frenchie68/Z79Forth/KIMG0091.jpg

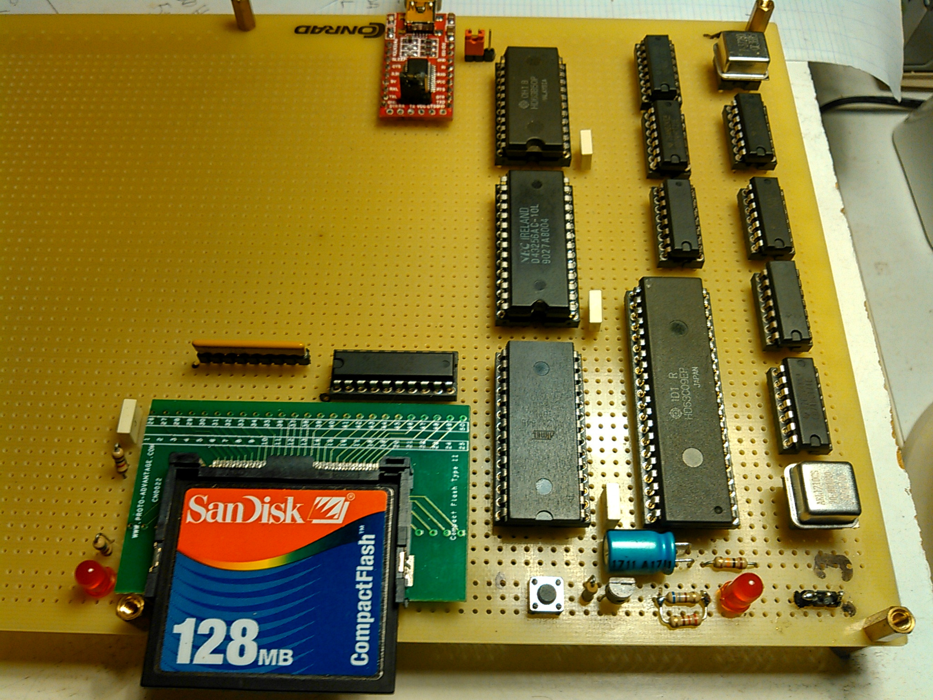
KIMG0091.jpg
