frenchie68/Z79Forth/HW/Z79Forth-iteration2.2.2.pdf

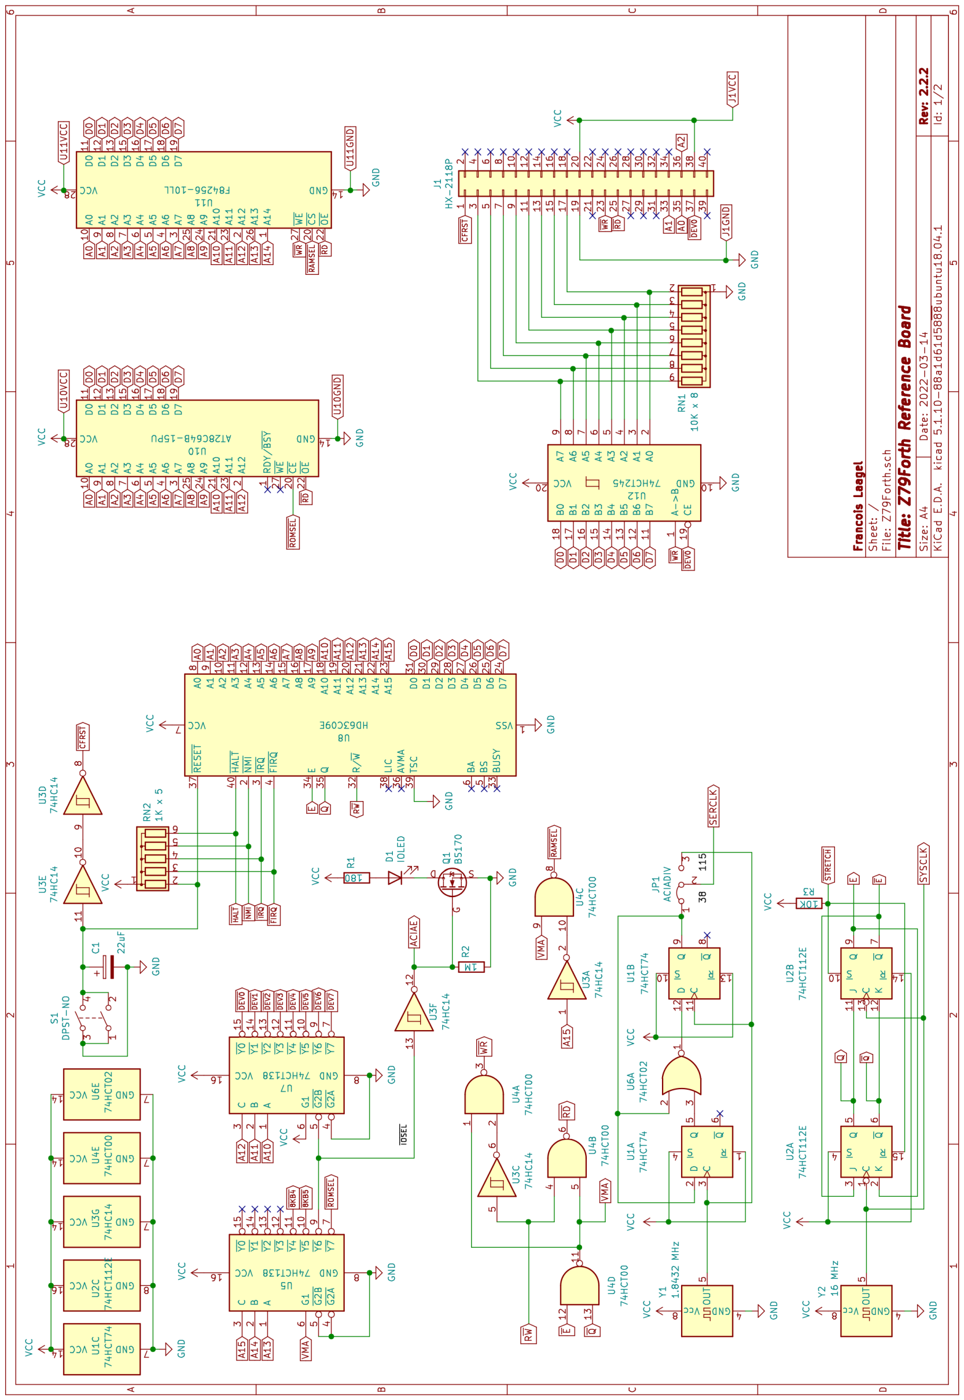
[picture p2: page 1]
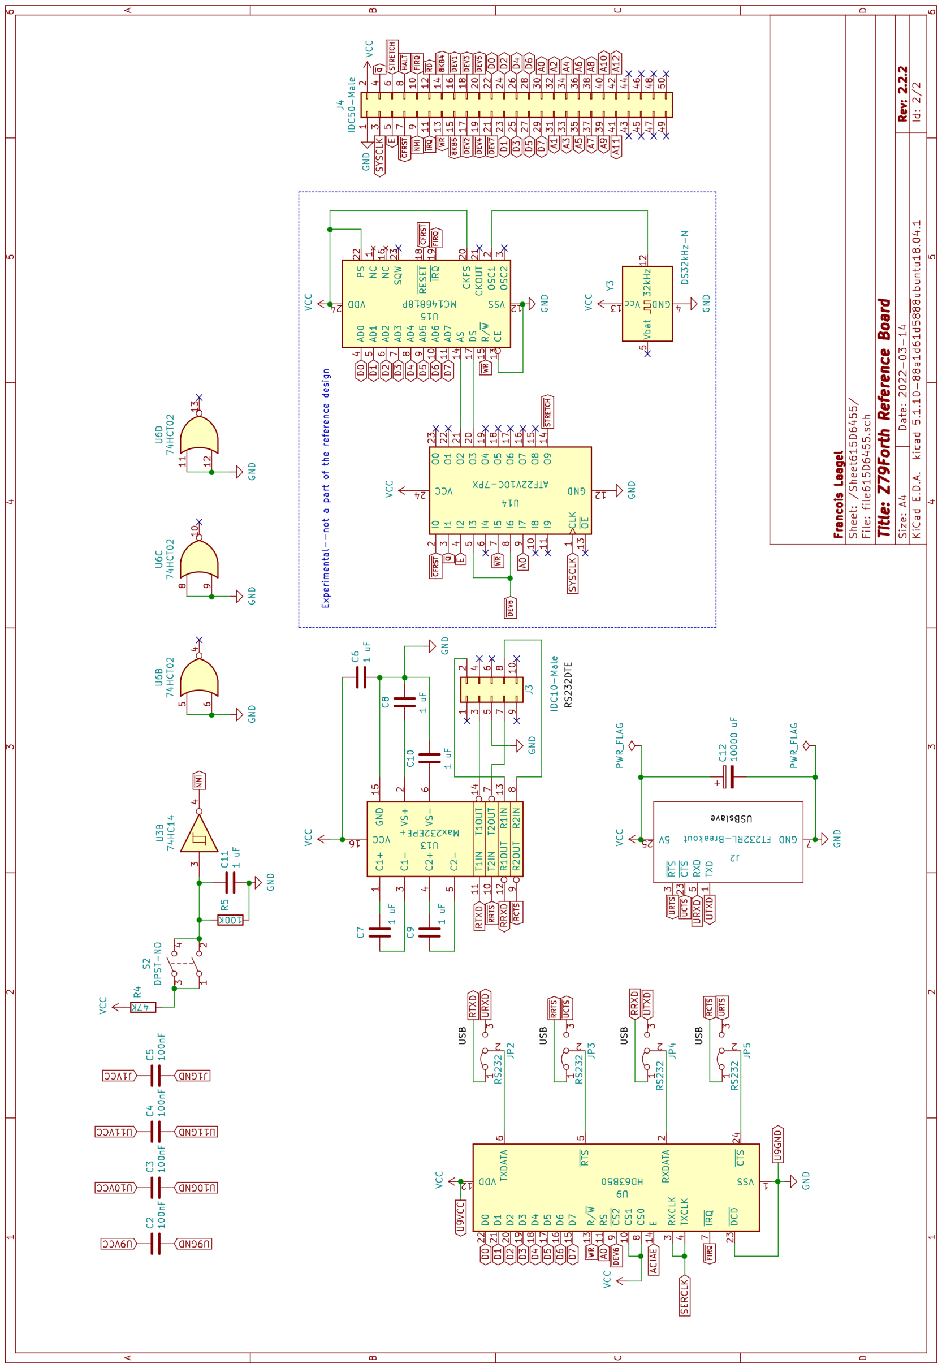
[picture p3: page 2]
