frenchie68/Z79Forth/HW/kicad5/Z79Forth.ods

Ref | Qnty | Value | Actual PN | Footprint | Description | Vendor | Sourcing status | Alternate reference
C1 | 1 | 22uF | C_Polarized |  | Polarized capacitor | Generic
C2, C3, C4, C5 | 4 | 100nF | C |  | Unpolarized capacitor | Generic
C6, C7, C8, C9, C10 | 5 | 1 uF | C |  | Unpolarized capacitor | Generic
D1 | 1 | IOLED | LED | 5 mm diameter | Red Light emitting diode | Generic
J1 | 1 | IDC40-Male | IDC40-Male | 2 rows of 20 pin headers (2.54 mm pitch) | Generic connector, double row, 40 pins, odd/even pin numbering scheme (row 1 odd numbers, row 2 even numbers) | Generic
J2 | 1 |  |  | PDIP28 (holes required for pins 1-9 and 20-28). 2 rows of 9 pin headers | FT232RL-Breakout module connection support | Az-delivery DE
J3 | 1 | IDC10-Male | IDC10-Male | 2 rows of 5 pin headers (2.54 mm pitch) | Generic connector, double row, 10 pins, odd/even pin numbering scheme (row 1 odd numbers, row 2 even numbers) | Generic
J4 | 1 | IDC50-Male | IDC50-Male | 2 rows of 25 pin headers (2.54 mm pitch) | Generic connector, double row, 50 pins, odd/even pin numbering scheme (row 1 odd numbers, row 2 even numbers) | Generic
JP1 | 1 | ACIADIV | Jumper_3_Bridged12 |  | Jumper, 3-pole, pins 1+2 closed/bridged | Generic
JP2, JP3, JP4, JP5 | 4 | RS232 | Jumper_3_Bridged12 |  | Jumper, 3-pole, pins 1+2 closed/bridged | Generic
Q1 | 1 | BS170 | BS170 | TO92 | N-MOSFET transistor, drain/gate/source | Fairchild/Onsemi | Mouser: not before 23/02. Farnell OK (E .4 a pop)
R1 | 1 | 180 | R | 250 mW vertically mounted | Resistor | Generic
R2 | 1 | 1M | R | 250 mW horizontally mounted | Resistor | Generic
R3, R4, R5 | 3 | 10K | R | 250 mW vertically mounted | Resistor | Generic
RN1 | 1 | 10K x 8 | R_Network08 | SIP9 | 8 resistor network, star topology, bussed resistors, small symbol | Bourns through-hole/generic
RN2 | 1 | 10K x 5 | R_Network05 | SIP6 | 5 resistor network, star topology, bussed resistors, small symbol | Bourns through-hole/generic
S1 | 1 | DPST-NO | SW_DPST | 6 x 6 mm | Double Pole Single Throw (DPST) Switch | Generic
U1 | 1 | 74HCT74 | CD74HCT74E | PDIP14 | Dual D Flip-flop, Set & Reset | Generic
U2 | 1 | 74HCT112E | CD74HCT112E | PDIP16 | Dual JK Flip-Flop, Set & Reset | Texas Instruments
U3 | 1 | 74HC14 | CD74HC14E | PDIP14 | Hex inverter schmitt trigger | Texas Instruments
U4 | 1 | 74HCT00 | CD74HCT00E | PDIP14 | quad 2-input NAND gate | Texas Instruments
U5, U7 | 2 | 74HCT138 | SN74HCT138N | PDIP16 | Decoder 3 to 8 active low outputs | Texas Instruments
U6 | 1 | 74HCT02 | SN74HCT02N | PDIP14 | quad 2-input NOR gate | Texas Instruments
U8 | 1 | HD63C09EP | HD63C09EP | PDIP40 | 8-Bit Microprocessing unit 3.0MHz, DIP-40 | Hitachi
U9 | 1 | HD63B50P | HD63B50P | PDIP24 | Asynchronous Communications Interface Adapter 1MHz, DIP-40 | Hitachi
U10 | 1 | AT28C64B-15PU | AT28C64B-15PU | PDIP28 | EEPROM 8 KB 150 ns | Atmel/Microchip | Sourced. (Mouser: 22/07) | https://www.mouser.fr/ProductDetail/Microchip-Technology-Atmel/AT28C64B-15PU
U11 | 1 | F84256-10LL | F84256-10LL | PDIP28 | SRAM 8 KB 100 ns | Fujitsu | Sourced. Wigi has more for a song | NEC D43256AC-10L
U12 | 1 | 74HCT245 | CD74HCT245E | PDIP20 | Octal BUS Transceivers, 3-State outputs | Texas Instruments
U13 | 1 | Max232IN | Max232IN | PDIP16 | Dual EIA-232 Drivers/Receivers | Maxim Integrated
Y1 | 1 | 1.84320 MHz | CXO_DIP8 | Oscillator:Oscillator_DIP-8 | Crystal Clock Oscillator, DIP8-style metal package | Quantek
Y2 | 1 | 16 MHz | CXO_DIP8 | Oscillator:Oscillator_DIP-8 | Crystal Clock Oscillator, DIP8-style metal package | AEL Crystals
unspec | 1 | HX-2118P | HX-2118P | N/A | ATA/CF 8 bit adapter | Ebay |  | https://m.alibaba.com/product/60814179118/Compact-Flash-CF-to-3-5.html
unspec | 1 | FT232RL-Breakout | FT232RL-Breakout | N/A | FT232RL-Breakout module | Az-delivery DE
unspec | 1 | SDCFB-128 | SDCFB-128 | N/A | SanDisk 128 MB (or larger) CompactFlash card | Ebay | Sourced
