frenchie68/Z79Forth/(threads)

Thread 4 (2021-02-05):

THRU does not do the right thing

frenchie68, 2021-02-05:
If invoked from block context, the current implementation (LOAD based) does not seem to be able to properly detect end of standalone blocks. It results in a return stack overflow. I do not clearly understand why, at this point.

I may very well be that a proper implementation should rely on BLOCK/INTERPRET instead.

frenchie68, 2021-03-01:
Fixed in Rel-1.0.2.

Closed 2021-03-01.

Thread 5 (2021-03-20):

POSTPONE Does Not Implement Proper ANSI Semantics

frenchie68, 2021-03-20:
Currently, POSTPONE is a straight alias to [COMPILE]. This means that its application to non-immediate words is problematic. This needs to be fixed and it will.

frenchie68, 2021-03-21:
This is fixed in master but not in any committed release as of yet.
Keeping the issue open until I can put an up to date release together.

frenchie68, 2021-04-05:
The issued has been fixed in the latest master "non-release."

Closed 2021-04-05.

Thread 6 (2021-05-12):

not a issue but why using 74hc14 ?

agsb, 2021-05-12:

frenchie68, 2021-05-13:
Hi Alvaro,

Actually, I do use an 74HC14. The schematics has just not been updated to reflect that.
This brings power consumption down by a few milli-amps.

Are you building the board? I am experimenting with interrupt support (FIRQ in native mode).
Ideally I will have interrupt based serial communications by the end of the weekend.

All the best.

        Francois

agsb, 2021-05-13:
Not for now, but i got curious about forth implementation and why use 74hct14 in main hardware design.
thanks.

frenchie68, 2021-06-18:
The use of a 74HC14 as a substitute for a 74HCT14 is a perfectly working option. I am operating under these conditions myself.

Closed 2021-06-18.

Thread 7 (2021-06-18):

S" skips leading spaces and it should not

frenchie68, 2021-06-18:
This leads to unfortunate outputs like the following:

."                foo" foo OK

This is not detected by the ANSI test suite-- not that it is an easy condition to detect anyway. Still,  I consider this problematic and I will work on a fix.

frenchie68, 2021-06-21:
Traced back to a faulty implementation of WORD.

frenchie68, 2021-06-23:
I now have an uncommitted fix for this. However, since my implementation of S" relies on WORD, it causes it to accept unwarranted leading delimiters whereas GNU Forth barfs (correctly) an error message. Case in point:

[Z79Forth]
S" """ABC" TYPE ABC OK
S" ABC" TYPE ABC OK

[GNU Forth]
S" """ABC" TYPE
:1: Undefined word
S" ">>>""ABC"<<< TYPE
Backtrace:
$7F692E7FAA08 throw
$7F692E810C90 no.extensions
$7F692E7FACC8 interpreter-notfound1

This is, of course, fixable as well but I do not really see the point. At this point, I have 18 bytes of EEPROM left and I will leave it at that.

frenchie68, 2021-07-08:
This issue is fixed in the REL-1.0.5 release.

Closed 2021-07-08.

Thread 9 (2021-07-17):

FORGET does not handle >IN properly

frenchie68, 2021-07-17:
BYE PAGE
HANLOAD 8 TOWERS [On interrupt] \<SPACE\> VLIST
towers Undefined

frenchie68, 2021-07-18:
This turns out not to be a problem--spurious bug report of some sort. Sorry about the noise.

Closed 2021-07-18.

Thread 10 (2021-08-09):

Bug in Schematics version 2.1

frenchie68, 2021-08-09:
Q# (U4 pin 13) is connected to U2 pin 8 and _not_ pin 9. I am not sure whether this will ever be fixed. The whole thing is meant to be replaced with version 2.2 schematics, aka the interrupt based serial communication architecture.

frenchie68, 2022-10-07:
WON'T FIX.

Closed 2022-10-07.

Thread 11 (2022-01-06):

>IN is not updated properly on number to string conversion or on non-immediate words when compiling

frenchie68, 2022-01-06:
This affects the currently published version of master as of this writing. This fix is trivial but unpublished as yet.

frenchie68, 2022-01-26:
Fixed in REL-2.0.1.

frenchie68, 2024-08-28:
This fix needs to be validated thoroughly.

Thread 19 (2023-08-27):

The CompactFlash Debug Code does not do what it's Supposed to

frenchie68, 2023-08-27:
A bug that will be invisible to most users but a bug nonetheless.
X is incorrectly used to point to a string buffer whereas Y should be used instead.

I came across this problem when attempting to debug a non-working SD to CF adapter from a non-descript manufacturer (QUMOX?). I am still missing a solution for that device.

frenchie68, 2023-11-25:
Closed in the REL-ANS94 branch. Master remains to be updated.

Closed 2023-11-25.

Thread 20 (2024-02-18):

ERRHDLR should EMIT an ASCII Shift in Before Anything

frenchie68, 2024-02-18:
This is an extremely marginal concern and yet I do care about it enough. When using alternate character sets on the VT420, the error handler does not currently switch back to the default character set. It _really_ should!

frenchie68, 2024-02-19:
Fixed in the ANS94 branch under REL-3.0.5. The master branch (79-STANDARD) will not get a fix.

Closed 2024-02-19.

Thread 23 (2024-10-22):

Hardware Bug - All schematics Versions

frenchie68, 2024-10-22:
A design flaw exists in the way the EEPROM interfaces to the system. This can cause the firmware to be corrupted and the board to be inoperable without re-flashing the EEPROM.

This happens, occasionally, when the system stack pointer register (S) clashes with the end of the dictionary.

Workaround: please connect pin #27 (WE#) to pin #28 (Vcc) of U10.

frenchie68, 2025-02-25:
Fixed with schematics v0_4, included in release 3.0.8.

Closed 2025-02-25.
