frenchie68/Z79Forth/HW/kicad6/schematics-v0_4.pdf

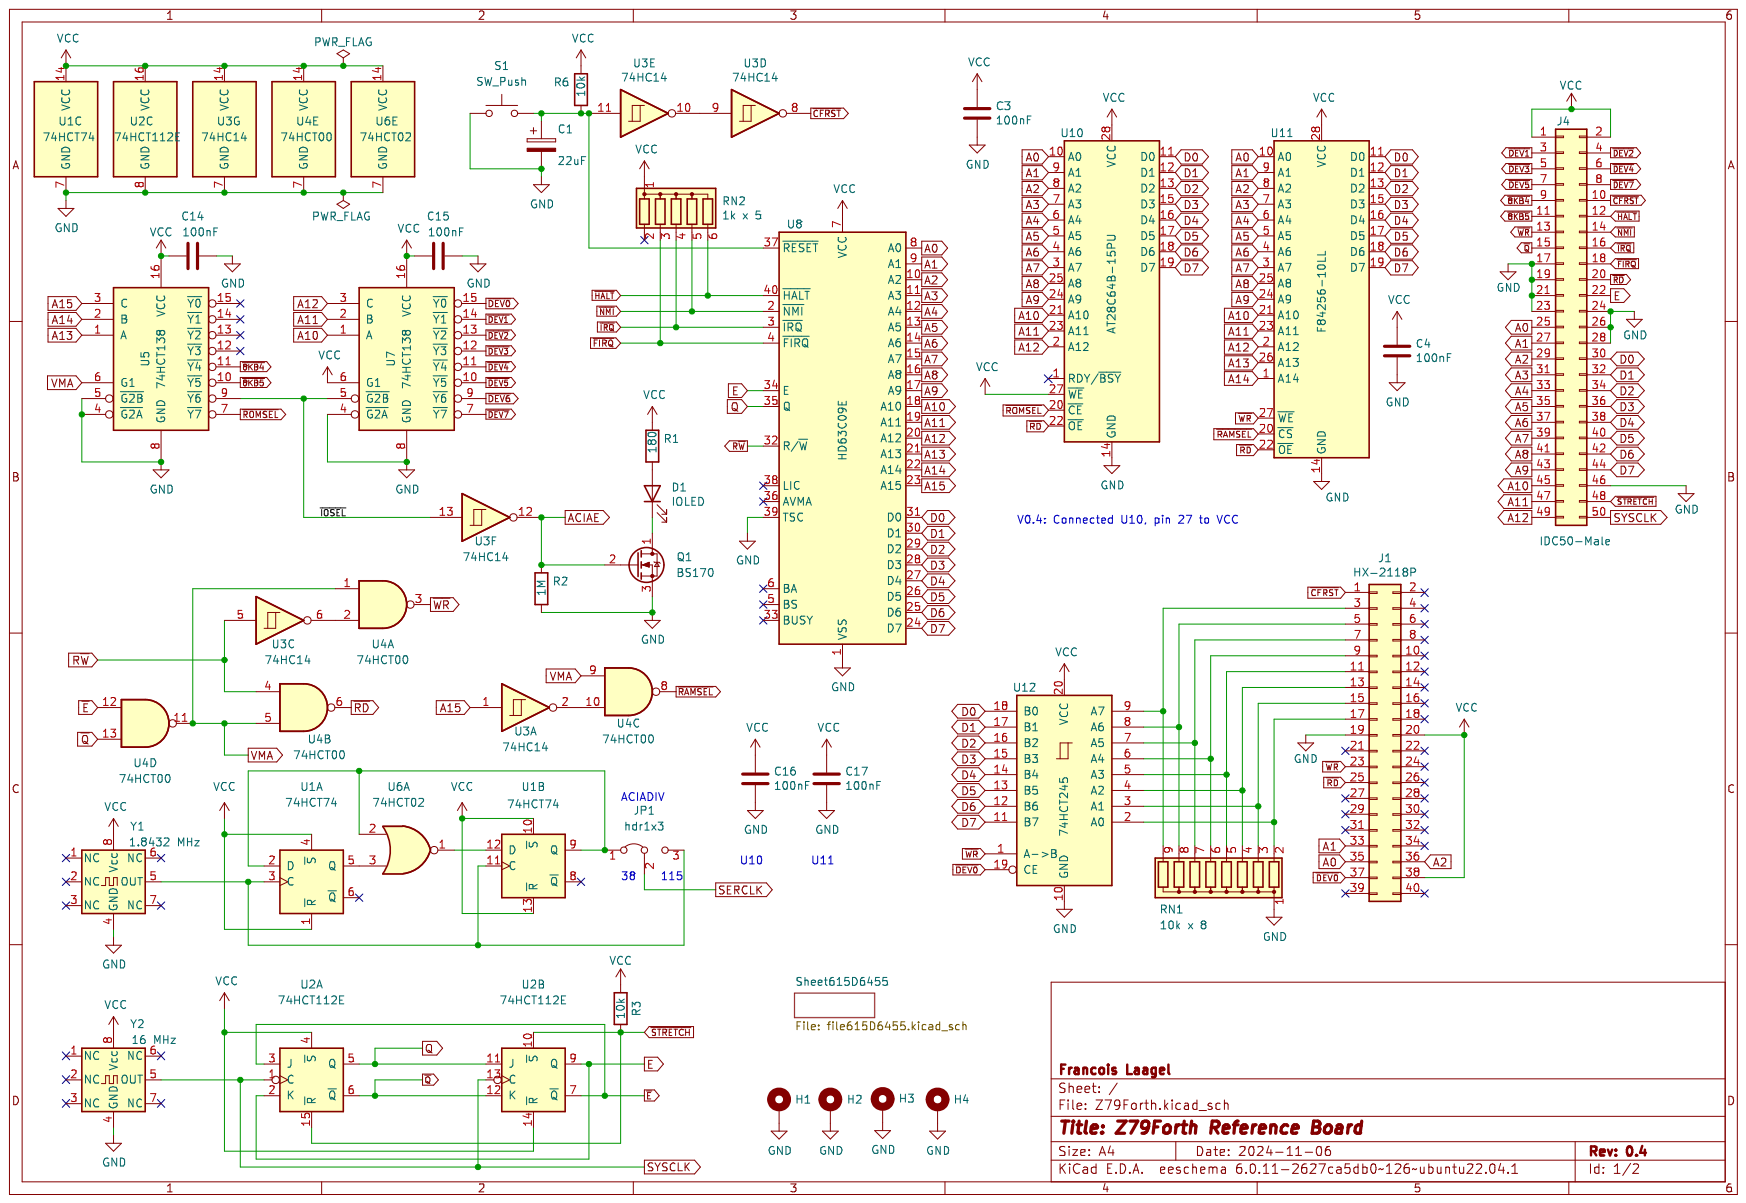
[picture p4: page 1]

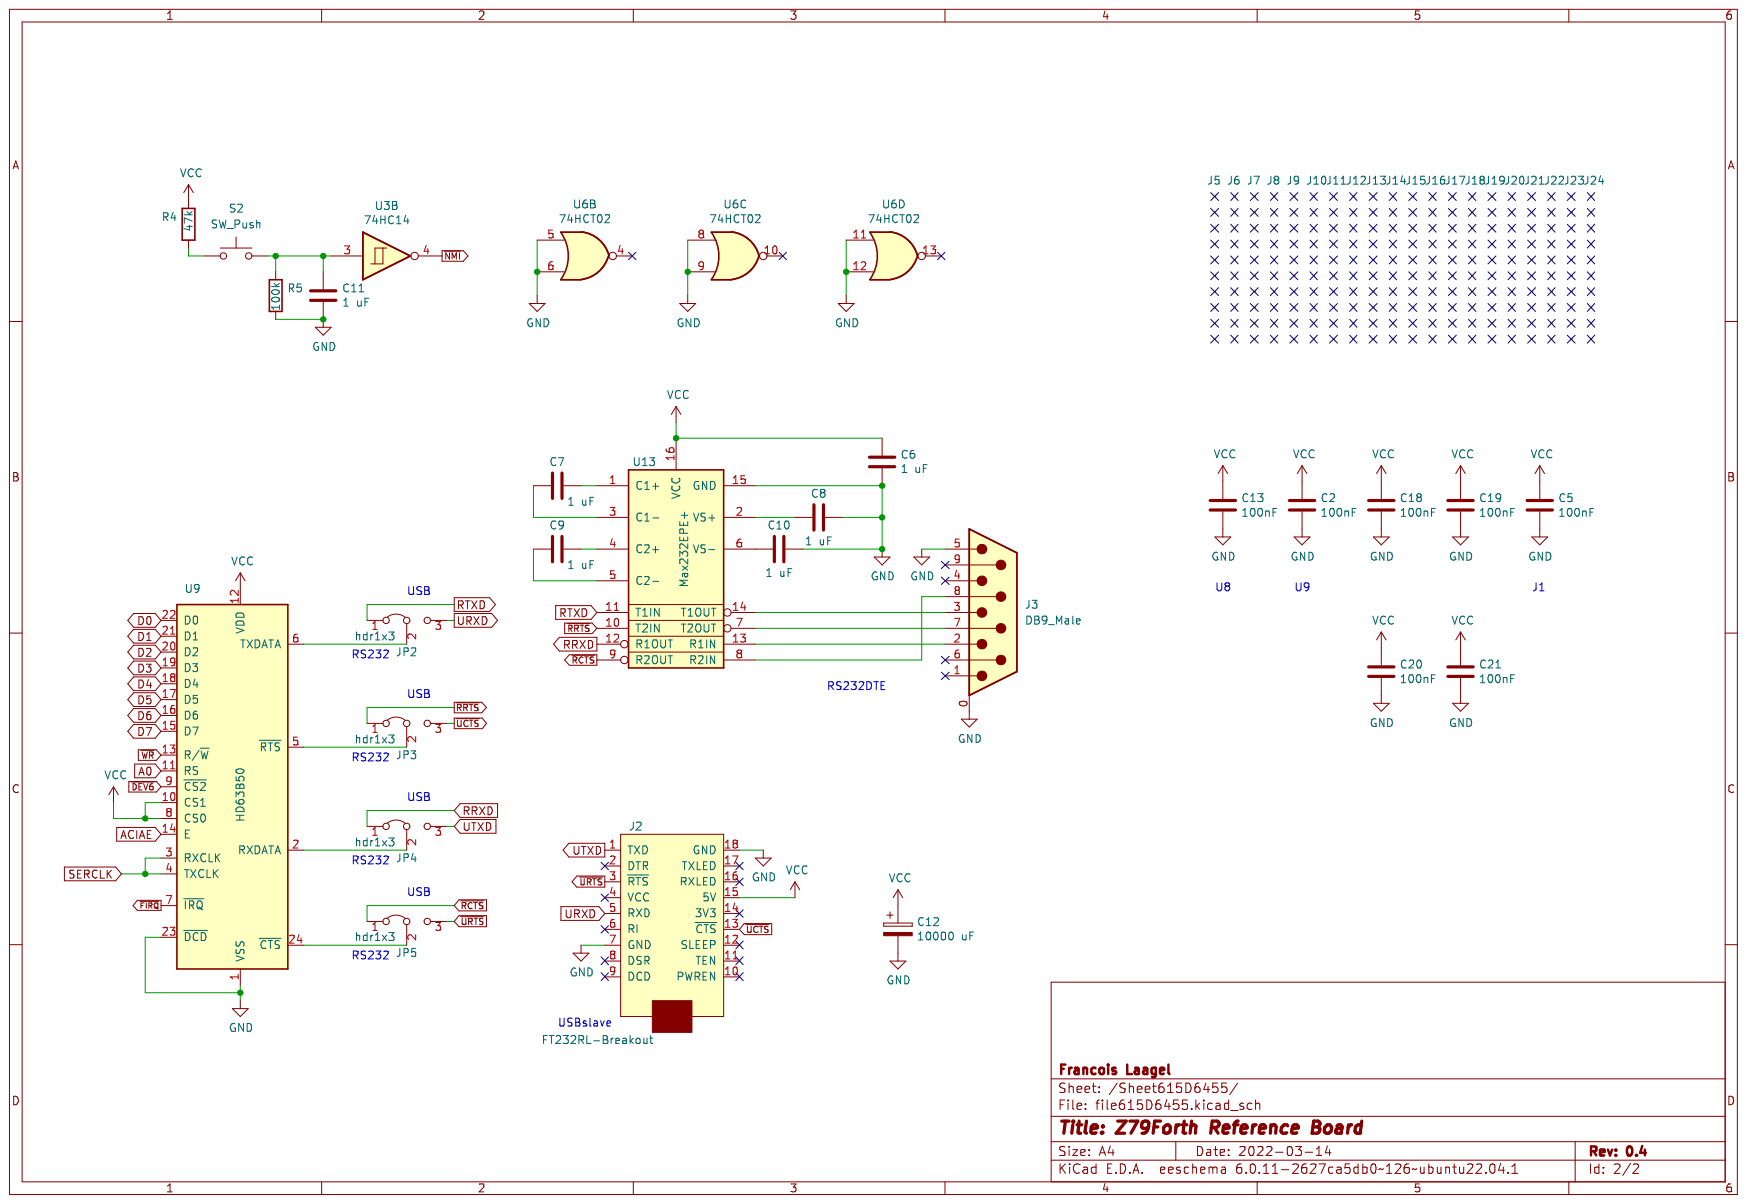
[picture p5: page 2]
