frenchie68/Z79Forth/HW/kicad6/schematics-v0_3.pdf

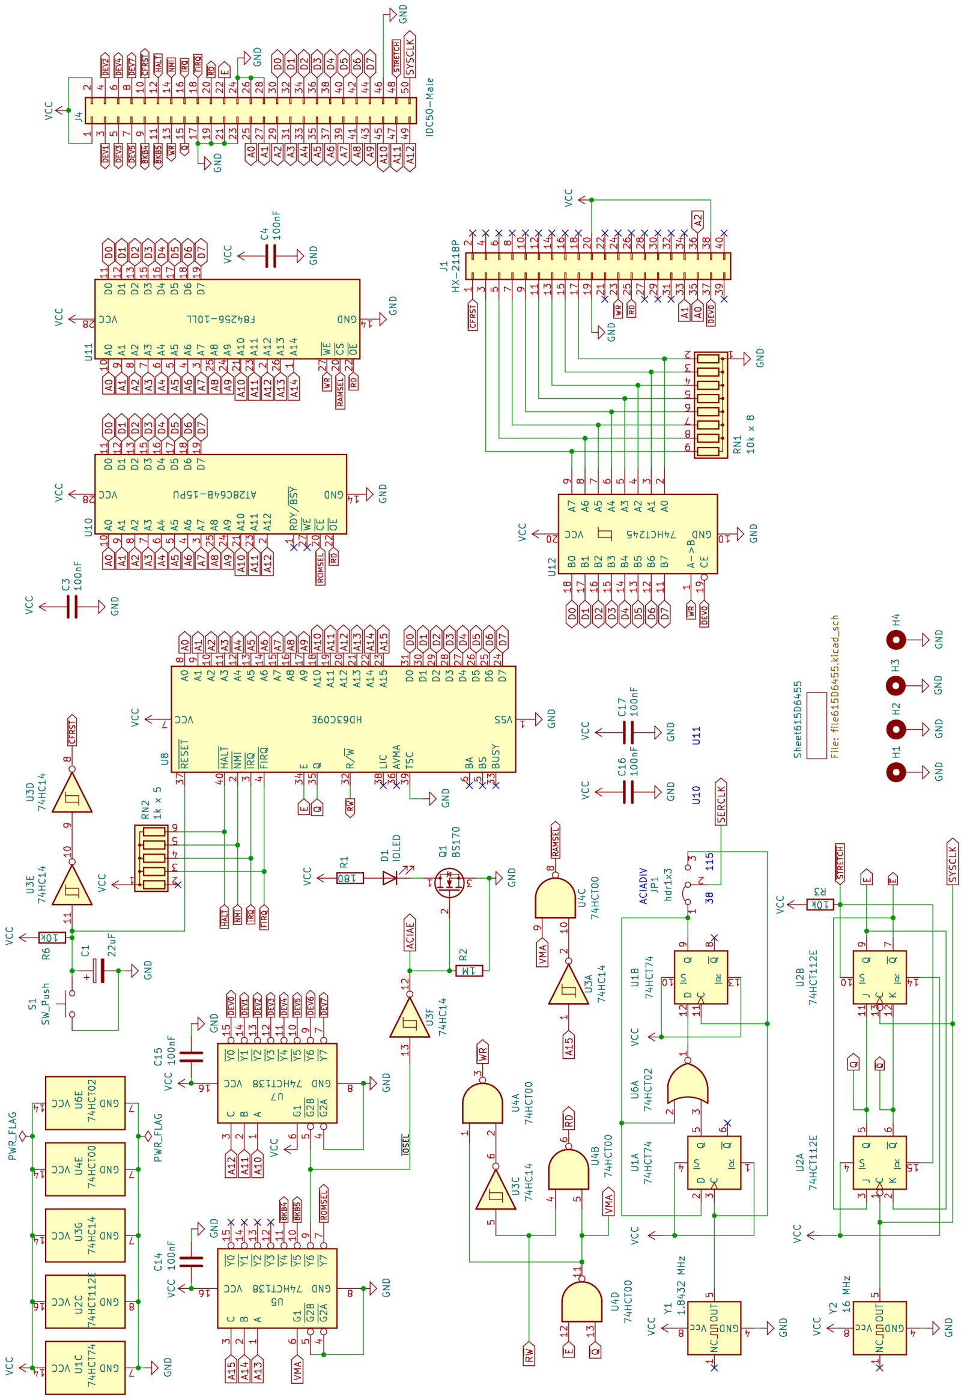
[picture p6: page 1]
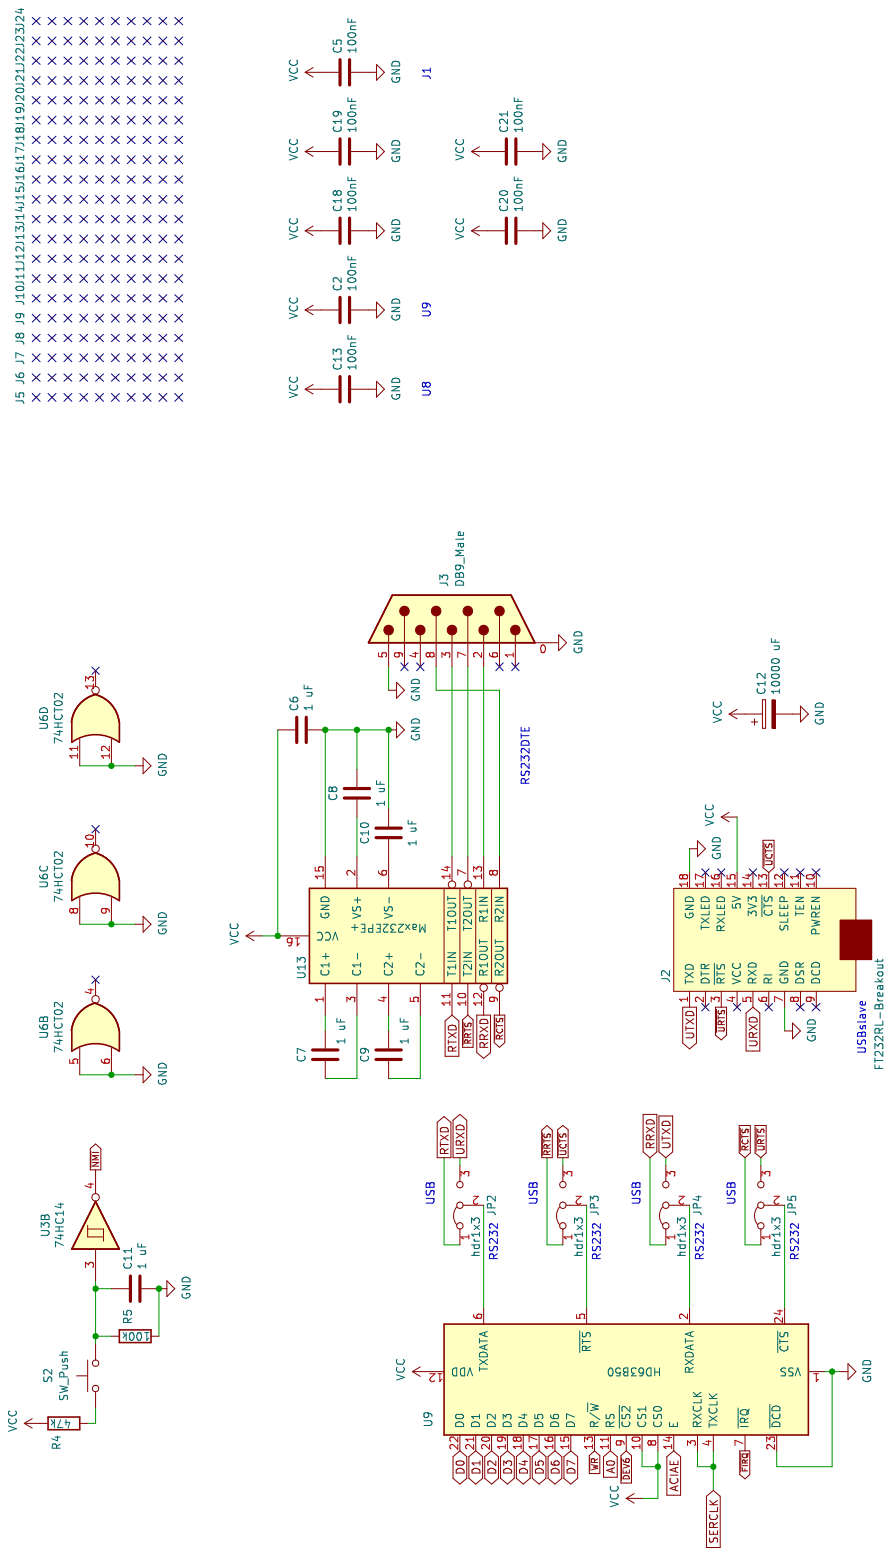
[picture p7: page 2]
