frenchie68/Z79Forth/HW/kicad5/Z79Forth.sch

## KiCad design HW/kicad5/Z79Forth.sch (2022-03-14)

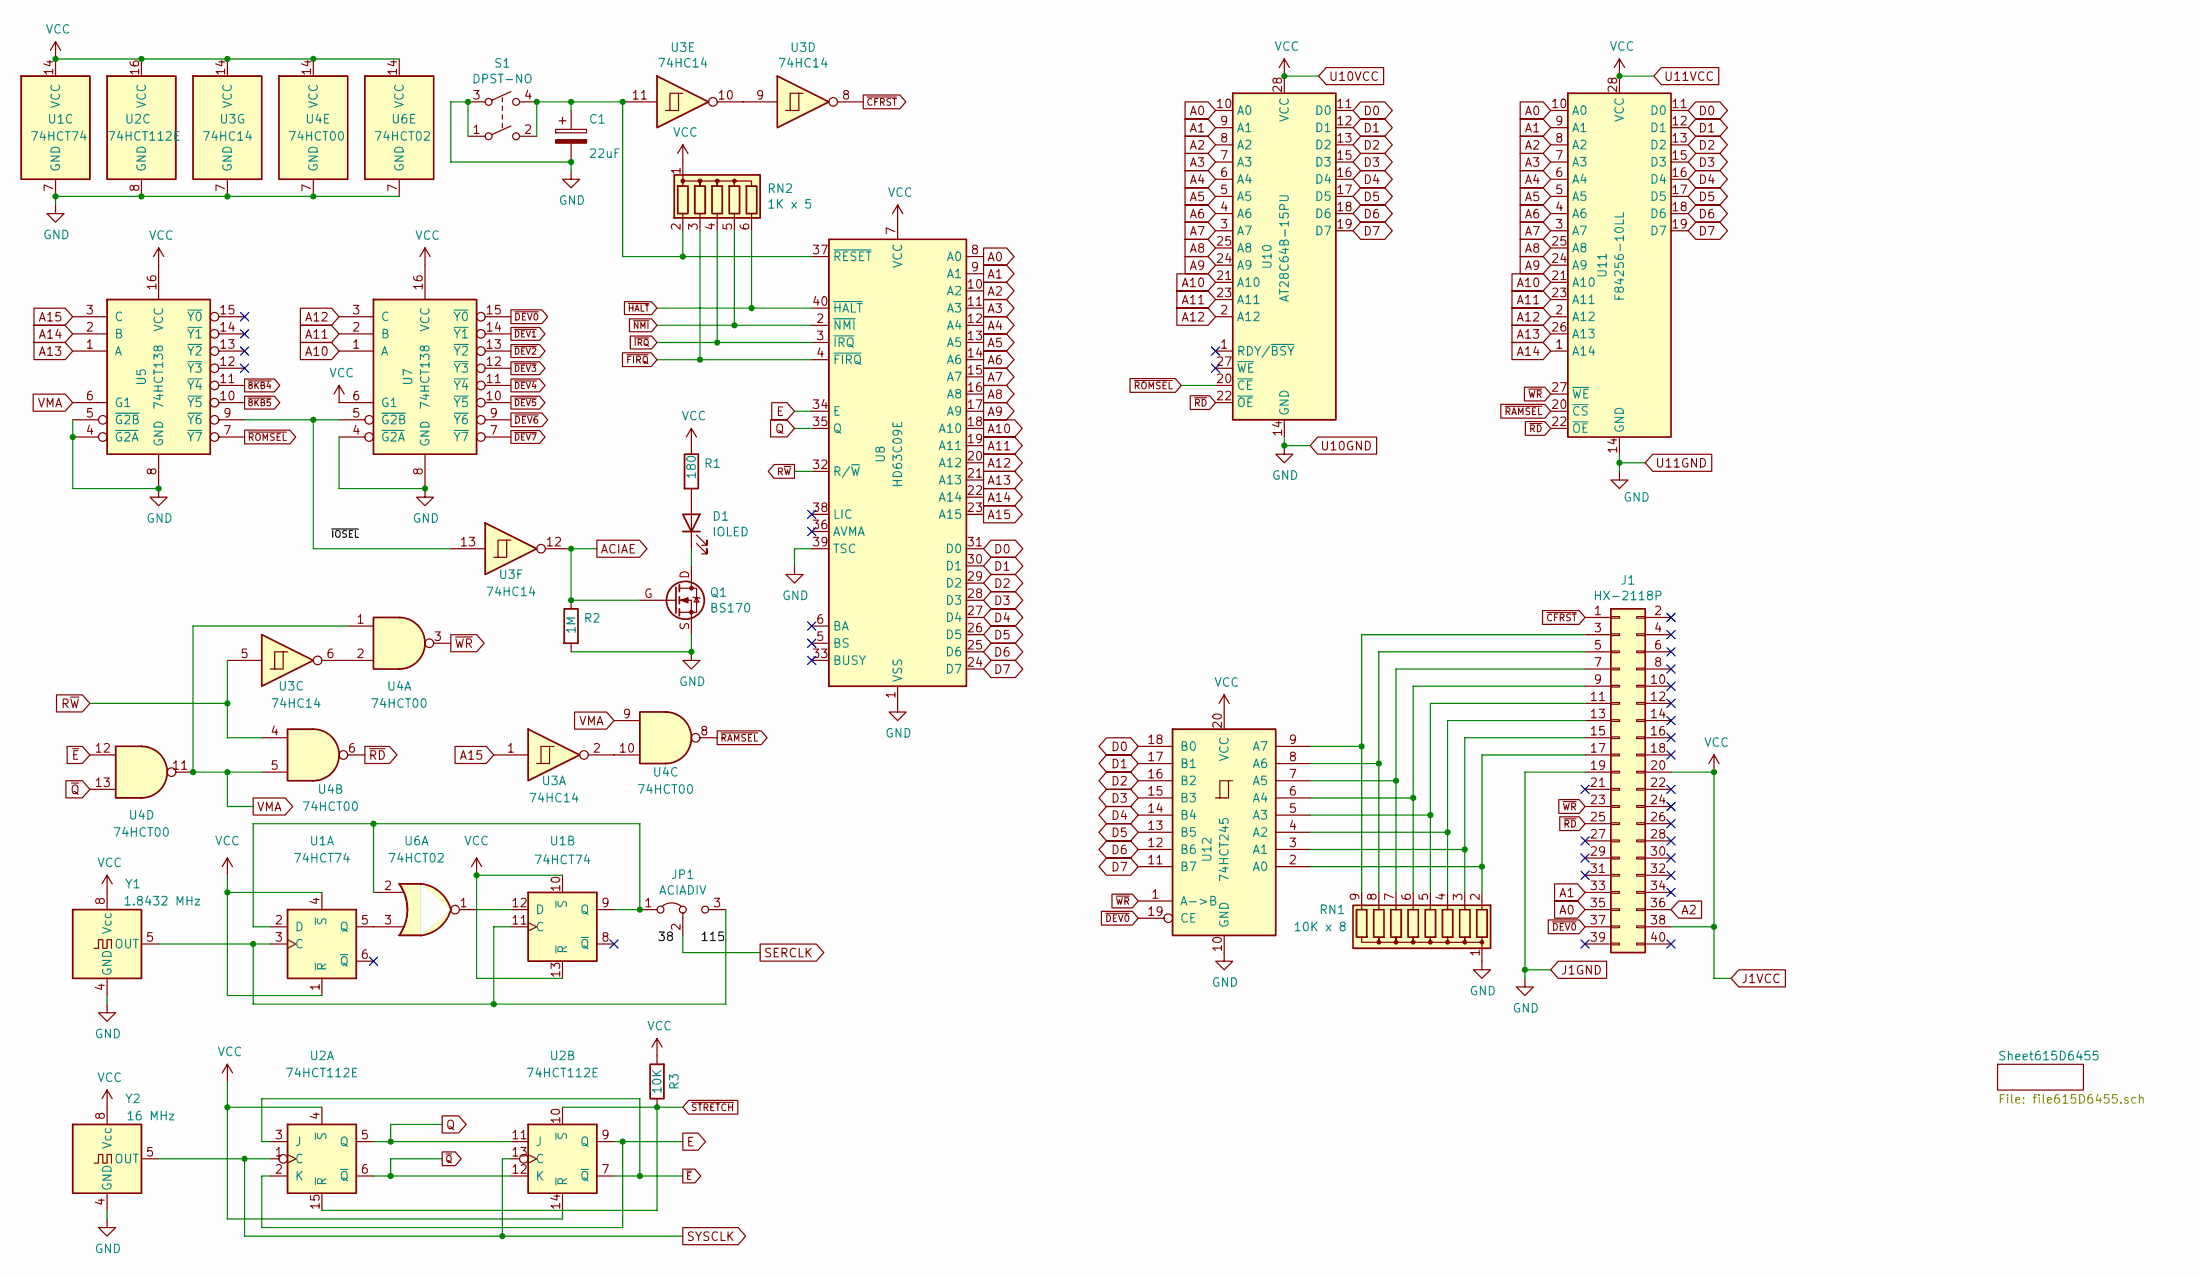
[picture p8: schematic Z79Forth.sch]

Parts:
C1: 22uF
D1: IOLED
J1: HX-2118P
JP1: ACIADIV
Q1: BS170
R1: 180
R2: 1M
R3: 10K
RN1: 10K x 8; R_Array_SIP9
RN2: 1K x 5; R_Array_SIP6
S1: DPST-NO
U1: 74HCT74
U2: 74HCT112E
U3: 74HC14
U4: 74HCT00
U5, U7: 74HCT138
U6: 74HCT02
U8: HD63C09E; DIP-40_W15.24mm
U10: AT28C64B-15PU; DIP-28_W15.24mm
U11: F84256-10LL; DIP-28_W15.24mm
U12: 74HCT245
Y1: 1.8432 MHz; Oscillator_DIP-8
Y2: 16 MHz; Oscillator_DIP-8

Connections:
A0: J1.35, U8.8 (A0), U10.10 (A0), U11.10 (A0)
A1: J1.33, U8.9 (A1), U10.9 (A1), U11.9 (A1)
A2: J1.36, U8.10 (A2), U10.8 (A2), U11.8 (A2)
A3: U8.11 (A3), U10.7 (A3), U11.7 (A3)
A4: U8.12 (A4), U10.6 (A4), U11.6 (A4)
A5: U8.13 (A5), U10.5 (A5), U11.5 (A5)
A6: U8.14 (A6), U10.4 (A6), U11.4 (A6)
A7: U8.15 (A7), U10.3 (A7), U11.3 (A7)
A8: U8.16 (A8), U10.25 (A8), U11.25 (A8)
A9: U8.17 (A9), U10.24 (A9), U11.24 (A9)
A10: U7.1 (A), U8.18 (A10), U10.21 (A10), U11.21 (A10)
A11: U7.2 (B), U8.19 (A11), U10.23 (A11), U11.23 (A11)
A12: U7.3 (C), U8.20 (A12), U10.2 (A12), U11.2 (A12)
A13: U5.1 (A), U8.21 (A13), U11.26 (A13)
A14: U5.2 (B), U8.22 (A14), U11.1 (A14)
A15: U3.1, U5.3 (C), U8.23 (A15)
ACIAE: Q1.G, R2.1, U3.12
D0: U8.31 (D0), U10.11 (D0), U11.11 (D0), U12.18 (B0)
D1: U8.30 (D1), U10.12 (D1), U11.12 (D1), U12.17 (B1)
D2: U8.29 (D2), U10.13 (D2), U11.13 (D2), U12.16 (B2)
D3: U8.28 (D3), U10.15 (D3), U11.15 (D3), U12.15 (B3)
D4: U8.27 (D4), U10.16 (D4), U11.16 (D4), U12.14 (B4)
D5: U8.26 (D5), U10.17 (D5), U11.17 (D5), U12.13 (B5)
D6: U8.25 (D6), U10.18 (D6), U11.18 (D6), U12.12 (B6)
D7: U8.24 (D7), U10.19 (D7), U11.19 (D7), U12.11 (B7)
E: U2.2 (K), U2.9 (Q), U8.34 (E)
GND: C1.2, J1.19, Q1.S, R2.2, RN1.1 (common), S1.1, S1.3, U1.7 (GND), U2.8 (GND), U3.7 (GND), U4.7 (GND), U5.4 (~G2A), U5.5 (~G2B), U5.8 (GND), U6.7 (GND), U7.4 (~G2A), U7.8 (GND), U8.1 (VSS), U8.39 (TSC), U10.14 (GND), U11.14 (GND), U12.10 (GND), Y1.4 (GND), Y2.4 (GND)
J1VCC: J1.20, J1.38, R1.1, R3.2, RN2.1 (common), U1.1 (~R), U1.4 (~S), U1.10 (~S), U1.13 (~R), U1.14 (VCC), U2.4 (~S), U2.14 (~R), U2.16 (VCC), U3.14 (VCC), U4.14 (VCC), U5.16 (VCC), U6.14 (VCC), U7.6 (G1), U7.16 (VCC), U8.7 (VCC), U10.28 (VCC), U11.28 (VCC), U12.20 (VCC), Y1.8 (Vcc), Y2.8 (Vcc)
unnamed: C1.1, RN2.2 (R1), S1.2, S1.4, U3.11, U8.37 (~RESET)
unnamed: D1.1 (K), Q1.D
unnamed: D1.2 (A), R1.2
unnamed: J1.3, RN1.9 (R8), U12.9 (A7)
unnamed: J1.5, RN1.8 (R7), U12.8 (A6)
unnamed: J1.7, RN1.7 (R6), U12.7 (A5)
unnamed: J1.9, RN1.6 (R5), U12.6 (A4)
unnamed: J1.11, RN1.5 (R4), U12.5 (A3)
unnamed: J1.13, RN1.4 (R3), U12.4 (A2)
unnamed: J1.15, RN1.3 (R2), U12.3 (A1)
unnamed: J1.17, RN1.2 (R1), U12.2 (A0)
unnamed: JP1.1 (A), U1.2 (D), U1.9 (Q), U6.2
unnamed: JP1.3 (B), U1.3 (C), U1.11 (C), Y1.5 (OUT)
unnamed: U1.5 (Q), U6.3
unnamed: U1.12 (D), U6.1
unnamed: U3.2, U4.10
unnamed: U3.6, U4.2
unnamed: U3.9, U3.10
unnamed: U3.13, U5.9 (~Y6), U7.5 (~G2B)
Q: U2.5 (Q), U2.11 (J), U8.35 (Q)
R~W: U3.5, U4.4, U8.32 (R/~W)
SERCLK: JP1.2 (C)
SYSCLK: U2.1 (C), U2.13 (C), Y2.5 (OUT)
VMA: U4.1, U4.5, U4.9, U4.11, U5.6 (G1)
~8KB4: U5.11 (~Y4)
~8KB5: U5.10 (~Y5)
~CFRST: J1.1, U3.8
~DEV0: J1.37, U7.15 (~Y0), U12.19 (CE)
~DEV1: U7.14 (~Y1)
~DEV2: U7.13 (~Y2)
~DEV3: U7.12 (~Y3)
~DEV4: U7.11 (~Y4)
~DEV5: U7.10 (~Y5)
~DEV6: U7.9 (~Y6)
~DEV7: U7.7 (~Y7)
~E: U2.3 (J), U2.7 (~Q), U4.12
~FIRQ: RN2.3 (R2), U8.4 (~FIRQ)
~HALT: RN2.6 (R5), U8.40 (~HALT)
~IRQ: RN2.4 (R3), U8.3 (~IRQ)
~NMI: RN2.5 (R4), U8.2 (~NMI)
~Q: U2.6 (~Q), U2.12 (K), U4.13
~RAMSEL: U4.8, U11.20 (~CS)
~RD: J1.25, U4.6, U10.22 (~OE), U11.22 (~OE)
~ROMSEL: U5.7 (~Y7), U10.20 (~CE)
~STRETCH: R3.1, U2.10 (~S), U2.15 (~R)
~WR: J1.23, U4.3, U11.27 (~WE), U12.1 (A->B)
