frenchie68/Z79Forth/HW/kicad5/file615D6455.sch

## KiCad design HW/kicad5/file615D6455.sch (2022-03-14)

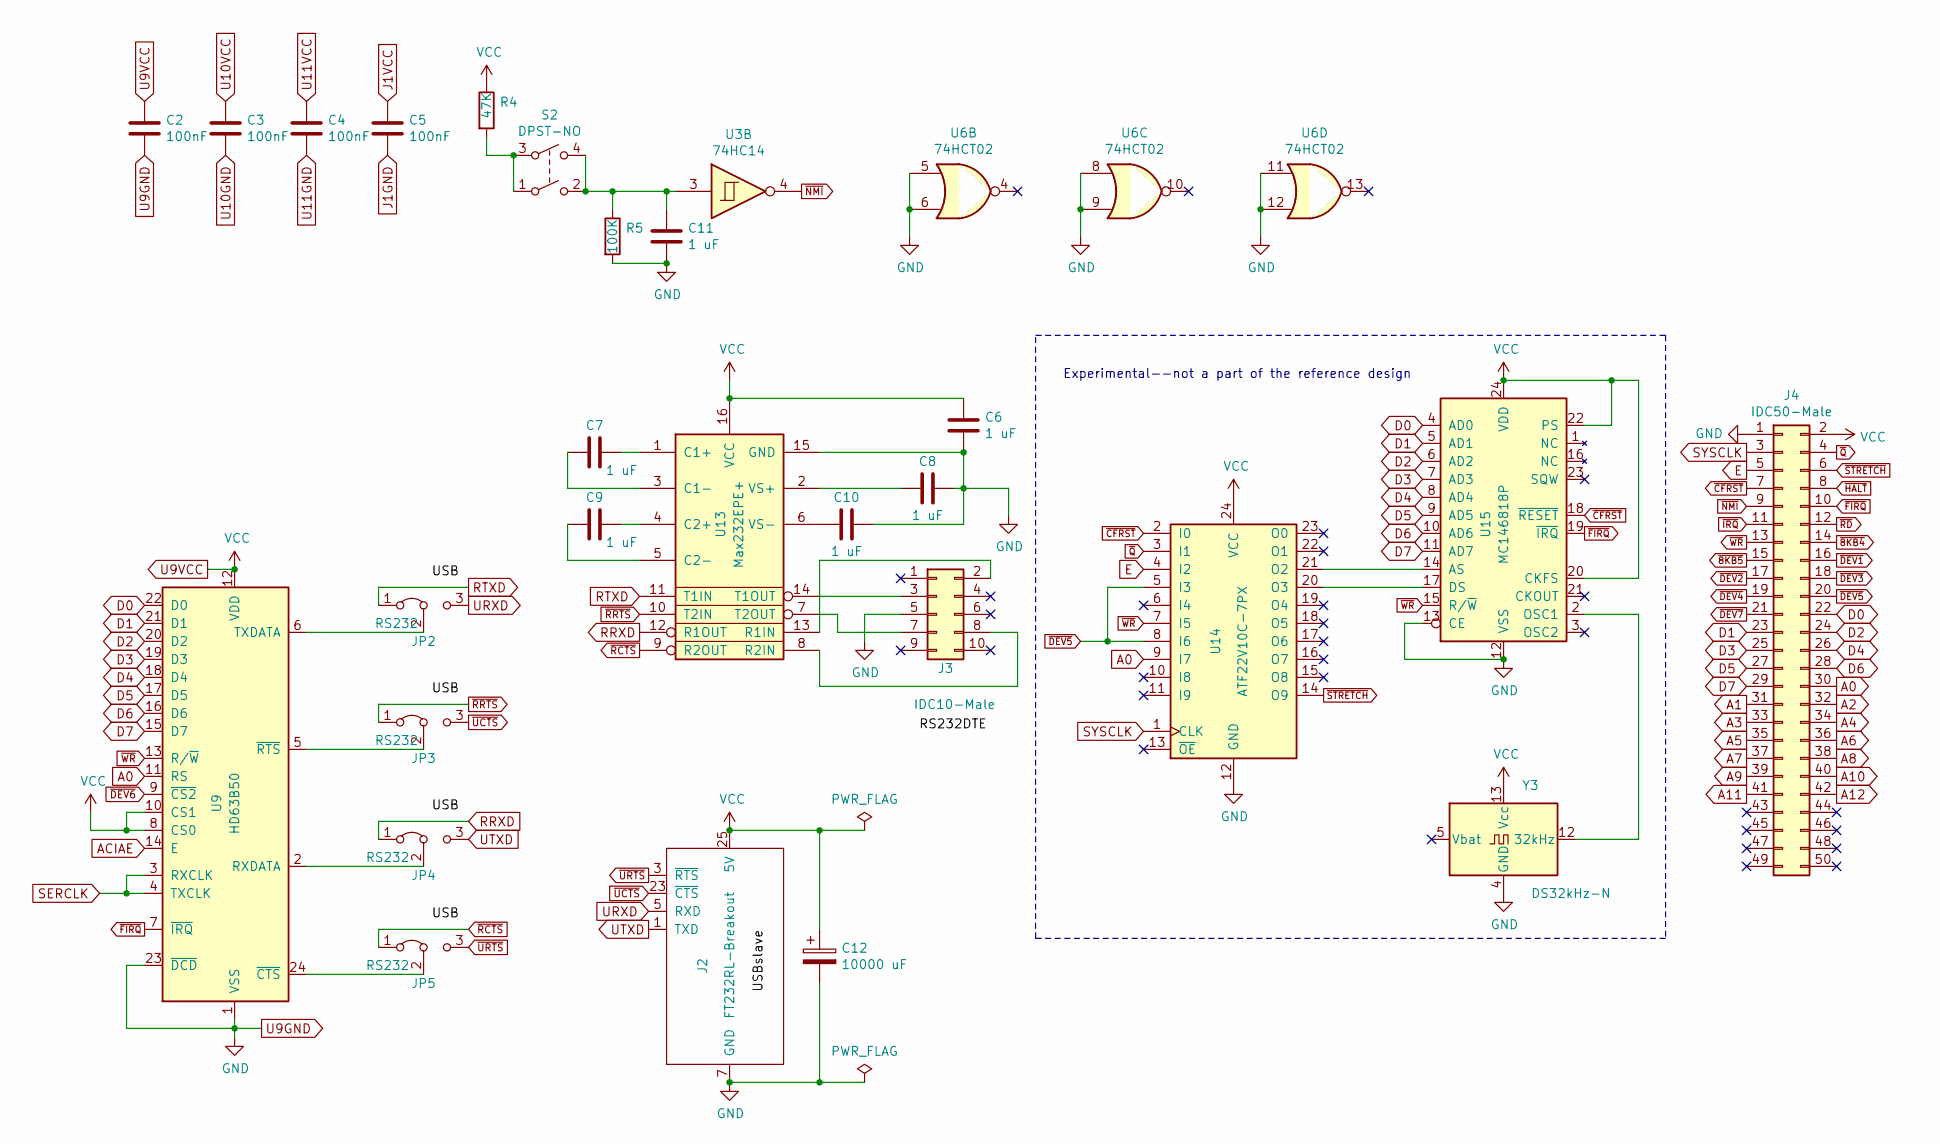
[picture p9: schematic file615D6455.sch]

Parts:
C2, C3, C4, C5: 100nF
C6, C7, C8, C9, C10, C11: 1 uF
C12: 10000 uF
J2: FT232RL-Breakout
J3: IDC10-Male
J4: IDC50-Male
JP2, JP3, JP4, JP5: RS232
R4: 47K
R5: 100K
S2: DPST-NO
U3: 74HC14
U6: 74HCT02
U9: HD63B50; DIP-40_W15.24mm
U13: Max232EPE+
U14: ATF22V10C-7PX
U15: MC146818P; DIP-40_W15.24mm
Y3: DS32kHz-N; Oscillator_DIP-14

Connections:
A0: J4.30, U9.11 (RS), U14.9 (I7)
A1: J4.31
A2: J4.32
A3: J4.33
A4: J4.34
A5: J4.35
A6: J4.36
A7: J4.37
A8: J4.38
A9: J4.39
A10: J4.40
A11: J4.41
A12: J4.42
ACIAE: U9.14 (E)
D0: J4.22, U9.22 (D0), U15.4 (AD0)
D1: J4.23, U9.21 (D1), U15.5 (AD1)
D2: J4.24, U9.20 (D2), U15.6 (AD2)
D3: J4.25, U9.19 (D3), U15.7 (AD3)
D4: J4.26, U9.18 (D4), U15.8 (AD4)
D5: J4.27, U9.17 (D5), U15.9 (AD5)
D6: J4.28, U9.16 (D6), U15.10 (AD6)
D7: J4.29, U9.15 (D7), U15.11 (AD7)
E: J4.5, U14.4 (I2)
GND: C2.2, C6.2, C8.2, C10.2, C11.2, C12.2, J2.7 (GND), J3.5, J4.1, R5.2, U6.5, U6.6, U6.8, U6.9, U6.11, U6.12, U9.1 (VSS), U9.23 (~DCD), U13.15 (GND), U14.12 (GND), U15.12 (VSS), U15.13 (CE), Y3.4 (GND)
J1GND: C5.2
J1VCC: C5.1
unnamed: C7.1, U13.3 (C1-)
unnamed: C7.2, U13.1 (C1+)
unnamed: C8.1, U13.2 (VS+)
unnamed: C9.1, U13.5 (C2-)
unnamed: C9.2, U13.4 (C2+)
unnamed: C10.1, U13.6 (VS-)
unnamed: C11.1, R5.1, S2.2, S2.4, U3.3
unnamed: J3.2, U13.13 (R1IN)
unnamed: J3.3, U13.14 (T1OUT)
unnamed: J3.7, U13.7 (T2OUT)
unnamed: J3.8, U13.8 (R2IN)
unnamed: JP2.2 (C), U9.6 (TXDATA)
unnamed: JP3.2 (C), U9.5 (~RTS)
unnamed: JP4.2 (C), U9.2 (RXDATA)
unnamed: JP5.2 (C), U9.24 (~CTS)
unnamed: R4.2, S2.1, S2.3
unnamed: U14.20 (O3), U15.17 (DS)
unnamed: U14.21 (O2), U15.14 (AS)
unnamed: U15.2 (OSC1), Y3.12 (32kHz)
RRXD: JP4.1 (A), U13.12 (R1OUT)
RTXD: JP2.1 (A), U13.11 (T1IN)
SERCLK: U9.3 (RXCLK), U9.4 (TXCLK)
SYSCLK: J4.3, U14.1 (CLK)
U9VCC: C2.1, C6.1, C12.1, J2.25 (5V), J4.2, R4.1, U9.8 (CS0), U9.10 (CS1), U9.12 (VDD), U13.16 (VCC), U14.24 (VCC), U15.20 (CKFS), U15.22 (PS), U15.24 (VDD), Y3.13 (Vcc)
U10GND: C3.2
U10VCC: C3.1
U11GND: C4.2
U11VCC: C4.1
URXD: J2.5 (RXD), JP2.3 (B)
UTXD: J2.1 (TXD), JP4.3 (B)
~8KB4: J4.14
~8KB5: J4.15
~CFRST: J4.7, U14.2 (I0), U15.18 (~RESET)
~DEV1: J4.16
~DEV2: J4.17
~DEV3: J4.18
~DEV4: J4.19
~DEV5: J4.20, U14.5 (I3), U14.8 (I6)
~DEV6: U9.9 (~CS2)
~DEV7: J4.21
~FIRQ: J4.10, U9.7 (~IRQ), U15.19 (~IRQ)
~HALT: J4.8
~IRQ: J4.11
~NMI: J4.9, U3.4
~Q: J4.4, U14.3 (I1)
~RCTS: JP5.1 (A), U13.9 (R2OUT)
~RD: J4.12
~RRTS: JP3.1 (A), U13.10 (T2IN)
~STRETCH: J4.6, U14.14 (O9)
~UCTS: J2.23 (~CTS), JP3.3 (B)
~URTS: J2.3 (~RTS), JP5.3 (B)
~WR: J4.13, U9.13 (R/~W), U14.7 (I5), U15.15 (R/~W)

Notes on the sheet:
Experimental--not a part of the reference design
