frenchie68/Z79Forth/(commit log)

2020-09-29 Create README.md
    This project has both a hardware component (a reference Hitachi HD63C09 SBC) and a software component: a Forth 79 standard subset completely implemented in assembly language. The hardware schematics will be uploaded later.
2020-10-20 Uploaded hardware schematics. Minor documentation changes.
2020-10-21 Add a bill of material to the hardware section.
2020-10-21 Add the 128 MB CompactFlash card to the BOM.
2020-11-04 Added embryonic HW/BLURB.txt. Switch schematics to rev 2.1.
2021-07-12 Simplify .' in case of a zero offset
2021-11-01 From now on, interrupt driven serial IO is the only supported mode (requires 2.2 schematics).
2021-11-04 Update README.md
    Document the transient nature of master as long as the hardware documentation does not describe interrupt based serial IOs.
2021-11-06 2.2 schematics release. SVG board layout description.
2021-11-06 Schematics 2.2: fix top view, add bottom view for the prototype board layout.
2021-11-07 Add 2.2 Kicad schematics.
    [Z79Forth.sch, file615D6455.sch]
2021-11-08 Add the clock stretching material to the hardware description.
2021-11-10 Update the BOM for 2.2 schematics wire wrapped prototype.
2022-01-19 SW/benchmarks: - bitsincell.4th: updated to take advantage of an optional MC146818 RTC (software support is disabled by default). SW/doc: - 79-STANDARD-docreq.txt 79-STANDARD-subset.txt updated conte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
2022-01-26 Update schematics to version 2.2.1.
    [Z79Forth.ods, Z79Forth.sch, file615D6455.sch]
2022-03-14 Schematics 2.2.2 (extension connector) fixes and to the description for D-.
    [Z79Forth.sch, file615D6455.sch]
2022-10-18 Data stack based control flow stack. PLOOPEX: (almost) ANS94 update mechanism. New words: :NONAME and AHEAD. PE
2023-11-24 Add the kicad6 v0.2 and v0.3 PCB design files.
    [Z79Forth.ods, Z79Forth.sch, file615D6455.sch]
2023-11-30 Fix Kicad6 assembly instructions.
2023-12-04 Assembly instructions fixes (HW/kicad6).
2023-12-23 Update PCB v0.3 assembly instructions (note about J1 shrouded connector).
2025-01-24 SW/examples: - hexadoku-z79.4th: . add the fix to 'speculate' that was already present in hexadoku-gen.4th (trivial problem, i.e. solved with no speculation whatsoever).
    SW/src/06_forth:
    - forth.asm:
    . get rid of NCLR and RCLR as Forth words.
    . ERRHDLR: FOB: print the SANRST string to restore some terminal sanity
    (restore default character set and re-enable the cursor).
    Those changes were introduced for better Pac-Man support.
    . BASALST: '&' no longer supported as a prefix for decimal.
    . set version to 20241017.
2025-02-25 - Add PCB v0_4 kikad6 design files. - Fix SW/examples/coop-mtask.4th for compatibility with firmware 20241017.
2025-04-01 Switch to a dedicated control flow stack and fix some of the examples.
2025-10-28 - make 'nbt' a double in examples/hexadoku-z79.4th. - add support for 'minipro' in Makefile (see 'make prog'). - take advantage of the generalized form of PULS to remove unnecessary references to RTS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
2026-06-29 Documentation update: specify flow control requirements for the terminal.
2026-06-30 src/06_forth/forth.asm: - reclaim two bytes of EEPROM from the '0=' (NULP) implementation. This probably could apply to other comparison operators. Also it is ground work for ANS94 compatible excepti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
2026-09-22 ERRHDLR: fix the incorrect display of the last parsed token, in case we're handling an uncaught EUNDEF exception. This matters mostly in block context (via LOAD/EVALUATE).
